MEGA65/mega65-kbd-pcb/(threads)

Thread 1 (2022-11-12):

Clearly mark pin 1 on SMD components to ease assembly

gardners, 2022-11-12:
IO expander ICs and also add inverted T orientation mark for the LEDs

Closed 2022-11-20.

Thread 10 (2022-11-12):

DEL, cursor keys jam because entire keyboard sits ~1mm too far up

gardners, 2022-11-12:
Addressed by #5 #6 #7 #8 and #9

Closed 2022-11-20.

Thread 4 (2022-11-12):

Add supports for SPACE bar

gardners, 2022-11-12:

gardners, 2022-11-20:
Modifying footprint for space bar, as normal foot-prints are too narrow.
Not 100% sure that spacing is correct as a result.
Also not sure about the footprint for the PCB stabilisers.  Ordering a set for comparison.

gardners, 2022-11-20:
Note to self: Should print out the cut file and overlay it over an original MEGA65 keyboard to test fit.

Closed 2022-11-20.

Thread 7 (2022-11-12):

Move H2 1mm towards rear

gardners, 2022-11-12:

gardners, 2022-11-20:
er, but #5 says move it 2mm

gardners, 2022-11-20:
1mm is likely to be correct, because the _distance_ between H1 and H2 matches that of the M65 MK-I keyboard I have here.
But 2mm might be correct after all, because that one doesn't fit super well.
I believe it should be 2mm. i.e. #5 is correct.

gardners, 2022-11-20:
Ah, I have of course confused myself: This is H2, not H1.

Closed 2022-11-20.

Thread 11 (2022-11-20):

left arrow (left of 1 key) is not connected to any IO expander

gardners, 2022-11-20:

gardners, 2022-11-20:
Was simply omitted in PCB design.  Could connect to one of the GPIO lines as a temporary fix, or cut trace on one of the duplicate < and > keys, and route it there.  The < and > key connections on U5 are the duplicates we are not using, so are the candidates for this.

Closed 2022-11-20.

Thread 12 (2022-11-20):

E key not connected to any IO expanders

gardners, 2022-11-20:

gardners, 2022-11-20:
Issue was mis-aligned label on U4 pin 4

gardners, 2022-11-20:
For ease of remedy, we will connect E to where GPIO1 was, and put GPIO1 on U4 pin 4

Closed 2022-11-20.

Thread 14 (2022-11-20):

Check PCB stabiliser mounting holes and positions on printout before ordering PCB

gardners, 2022-11-20:
Positions and sizes etc are uncertain. Check before spending $ on PCBs

gardners, 2022-11-20:
1. Wait for keyboard stabilisers to arrive, and confirm footprints
2. Try to convince printer to print without scaling, so that I can fit-test holes.

gardners, 2022-11-20:
3. Add copper/solder rings around mounting holes for key stabilisers, so that the nut and washer can't damage tracks beneath them (in theory only "front" of PCB is at risk, as "back" is the side the keys and stabilisers insert into).

Thread 15 (2022-11-22):

Add 6.25x or 6.75x mounting holes for space bar

gardners, 2022-11-22:
For people building their own keyboard, and not able to get genuine MEGA65 keycaps, they are unlikely to find a 170mm long space bar.  Thus we should add 6.25x or 6.75x support holes for the space bar as well.

Closed 2022-11-24.

Thread 16 (2022-11-25):

Fix intermittant white flash of drive LEDs

gardners, 2022-11-25:
Most likely caused by the periodic resetting of the IO expander DDRs on the one that controls the LEDs not being synchronised to the I2C traffic, thus causing u1_active to be able to go low after the I2C transaction has commenced, thus causing the LEDs to be briefly written as on.

gardners, 2022-11-26:
Fixed in mk2_to_mk1.vhdl for the appropriate targets.

Closed 2022-11-26.
