MEGA65/mega65-kbd-pcb/(commit log)

2022-10-28 begin preparing part selection and footprints
    [mega65-kbd.kicad_pcb, mega65-kbd.kicad_sch]
2022-10-28 add IO expanders and connect LEDs
    [mega65-kbd.kicad_sch]
2022-10-28 connect I2C bus and keyboard connector
    [mega65-kbd.kicad_sch]
2022-10-29 begin placing keys
    [keyswitches.kicad_sch, mega65-kbd.kicad_pcb, mega65-kbd.kicad_sch]
2022-10-29 place top row of key switches
    [keyswitches.kicad_sch, mega65-kbd.kicad_pcb, mega65-kbd.kicad_sch]
2022-10-29 place 2nd row of keys
    [mega65-kbd.kicad_pcb]
2022-10-29 finish placing keys.. but they are backwards...
    [mega65-kbd.kicad_pcb]
2022-10-29 add rectangle outline and place remaining components
    [mega65-kbd.kicad_pcb]
2022-10-29 add and place mounting holes
    [keyswitches.kicad_sch, mega65-kbd.kicad_pcb, mega65-kbd.kicad_sch]
2022-10-29 finish placing LEDs and resistors
    [keyswitches.kicad_sch, mega65-kbd.kicad_pcb, mega65-kbd.kicad_sch]
2022-10-29 connect GND to all keys
    [mega65-kbd.kicad_pcb]
2022-10-29 progress with connecting I2C IO extenders
    [mega65-kbd.kicad_pcb]
2022-10-29 finish routing I2C IO extenders
    [mega65-kbd.kicad_pcb]
2022-10-29 route two IO expanders worth of keys
    [mega65-kbd.kicad_pcb, mega65-kbd.kicad_sch]
2022-10-29 route 3rd IO expander
    [mega65-kbd.kicad_pcb, mega65-kbd.kicad_sch]
2022-10-29 route 4th IO expander
    [mega65-kbd.kicad_pcb, mega65-kbd.kicad_sch]
2022-10-29 route 5th IO expander
    [mega65-kbd.kicad_pcb, mega65-kbd.kicad_sch]
2022-10-29 resolve all DRC errors and warnings
    [keyswitches.kicad_sch, mega65-kbd.kicad_sch]
2022-10-29 tweak PCB appearance
    [keyswitches.kicad_sch, mega65-kbd.kicad_sch]
2022-10-29 add further annotations to the PCB
2022-10-29 add label for keyboard cable to MEGA65
2022-10-29 add note about fitting into real MEGA65 case
2022-10-29 improve keyswitch footprint to show key IDs
    [keyswitches.kicad_sch]
2022-10-29 add missing I2C pull-ups (thanks michael :)
    [mega65-kbd.kicad_sch]
2022-10-29 finish adding missing I2C pull-ups
    [keyswitches.kicad_sch, mega65-kbd.kicad_sch]
2022-11-20 fix #12
    [mega65-kbd.kicad_sch]
2022-11-20 fix #13
    [mega65-kbd.kicad_sch]
2022-11-20 swap E and LARR with GPIO1 and GPIO2 to solve #11, #12 and #13
    [mega65-kbd.kicad_sch]
2022-11-20 move RETURN key switch to correct position #3
2022-11-20 use 2.0x footprint for RETURN to get support mounting holes
2022-11-20 fix all DRC warnings. begin adding pin 1 SMD markers
    [keyswitches.kicad_sch, mega65-kbd.kicad_sch]
2022-11-20 add pin 1 markers for SMD chips #1
2022-11-20 add orientation marker for LEDs #1
2022-11-20 move vias away from space bar stabiliser wire and silkscreening
2022-11-24 add 6.25x support holes for space bar. #15
2022-11-25 improve keyboard labels. Remove unneeded LED silkscreening
2022-11-26 fix GPIO header silkscreen positions. improve IC part text
2022-11-26 fix trace too close to edge and tidy up other traces
